brumaombra/wall-scanner/docs/oscilloscopio-segnale.jpg

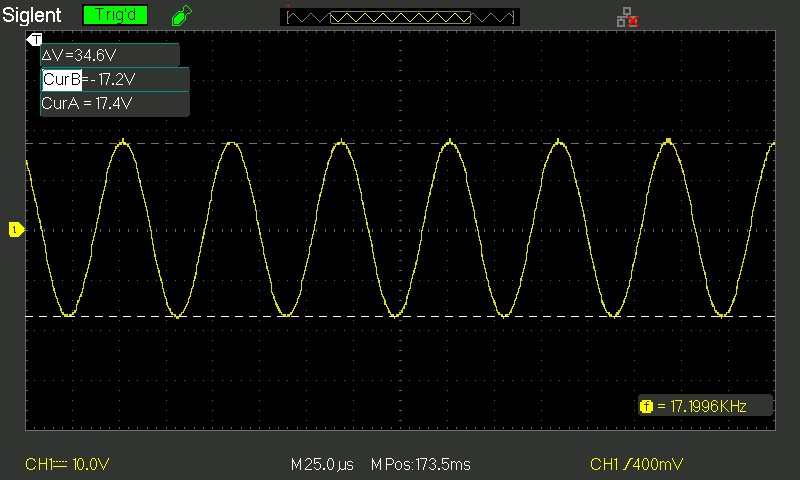
docs/oscilloscopio-segnale.jpg
