brumaombra/wall-scanner/docs/simulazione-comparatore.png

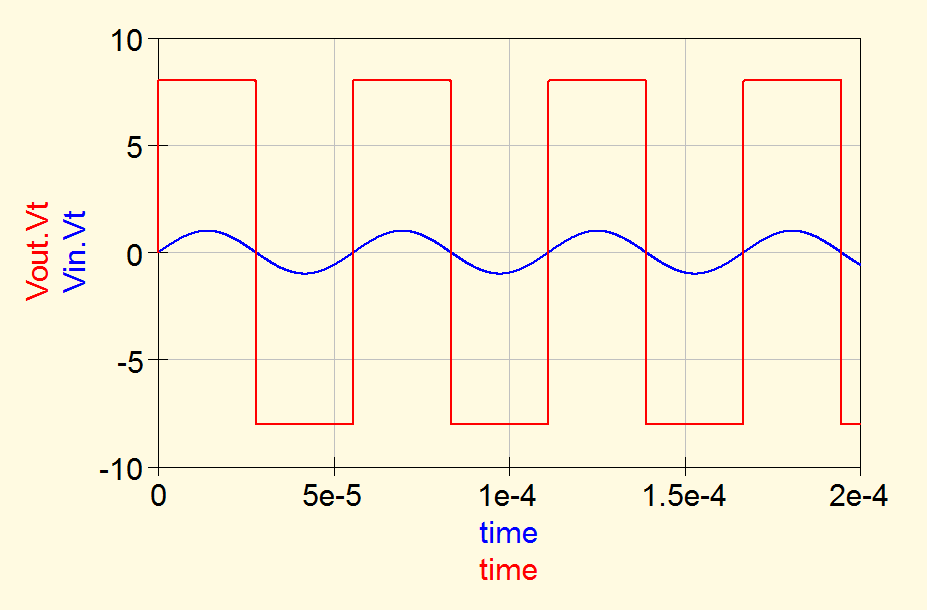
docs/simulazione-comparatore.png
