brumaombra/wall-scanner/docs/web-app-page-2.png

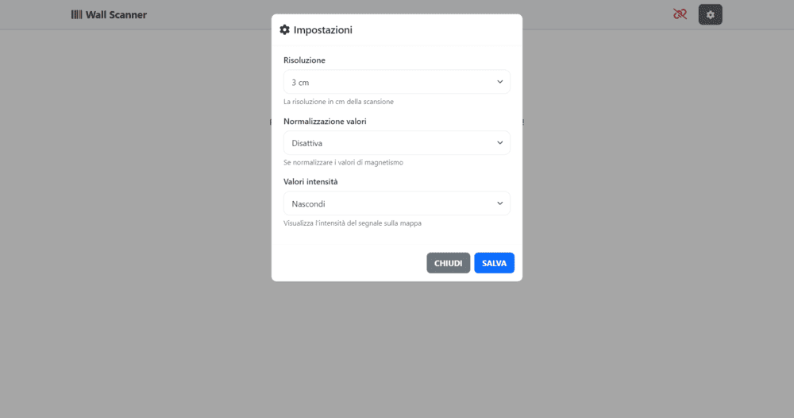
docs/web-app-page-2.png
