brumaombra/wall-scanner/(commit log)

2024-01-11 Better visualization + CSV examples
    [record_1.csv, record_2.csv]
2024-01-14 Added settings
    [record_1.csv, record_2.csv]
2024-03-31 Tolti interrupt
2024-04-02 Migliorata UX pagina web + test libreria mouse
    [record_1.csv, record_2.csv]
2024-04-03 Aggiunta visualizzazione calibrazione + minor bug fix
    [main.cpp]
2024-04-04 Fix reset coordinate + altri fix
    [main.cpp]
2024-04-07 Lampeggio errore con due LED
    [main.cpp]
2025-10-05 Aggiornato il README.md con una descrizione dettagliata del progetto, punti chiave, interfaccia e istruzioni per l'installazione.
2025-10-06 Add documentation and improve code readability; include new images for wall scanner and web app interface
    - Added new GIF and image files for documentation: scan.gif, wall-scanner-elements.jpg, wall-scanner-versions.png, web-app-page-1.png, web-app-page-2.png, web-app-page-settings.gif.
    - Updated PS2MouseHandler class comments and formatting for clarity.
    - Refactored main.cpp to improve comments and variable naming for better understanding.
    - Removed unnecessary comments and improved existing ones to enhance code readability.
    - Simplified PlatformIO configuration file by removing commented-out sections.
    - Enhanced LED and beeper functions with clearer comments and consistent naming conventio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
