brumaombra/wall-scanner/(notices)

Notices in the files:
README.md:
License: MIT
